akashks2006/Ball_Balancing_Robot/Images/image1.jpeg

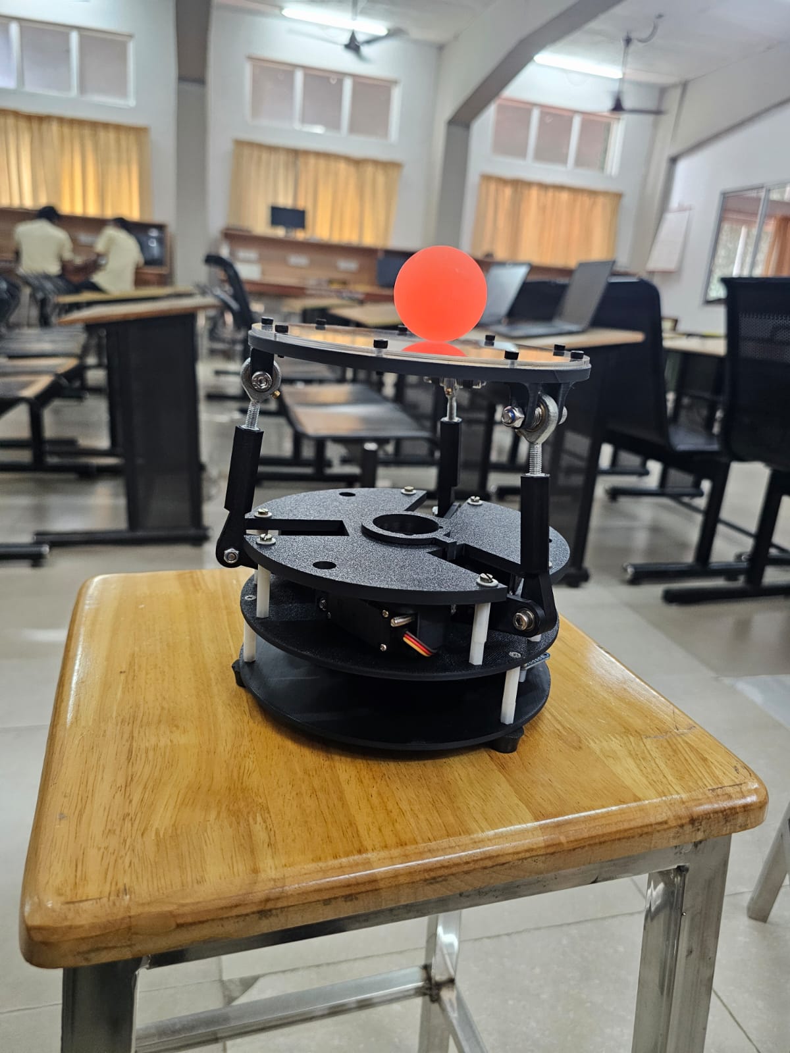
Images/image1.jpeg
