akashks2006/Ball_Balancing_Robot/Images/image2.jpeg

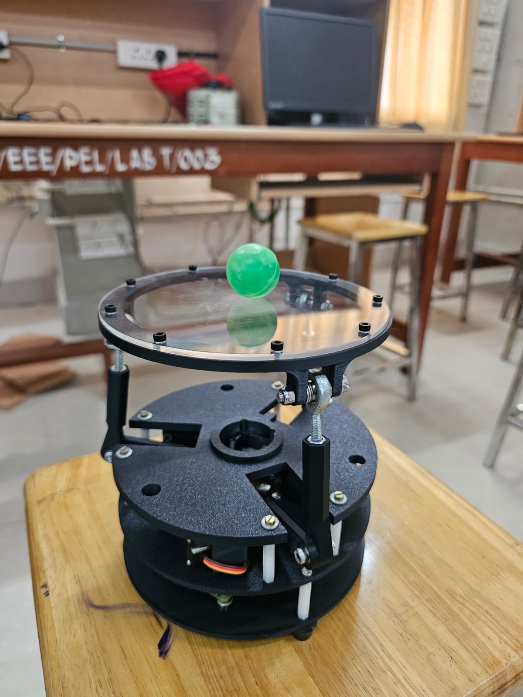
Images/image2.jpeg
