akashks2006/Ball_Balancing_Robot/Images/Simulation Dashboard.png

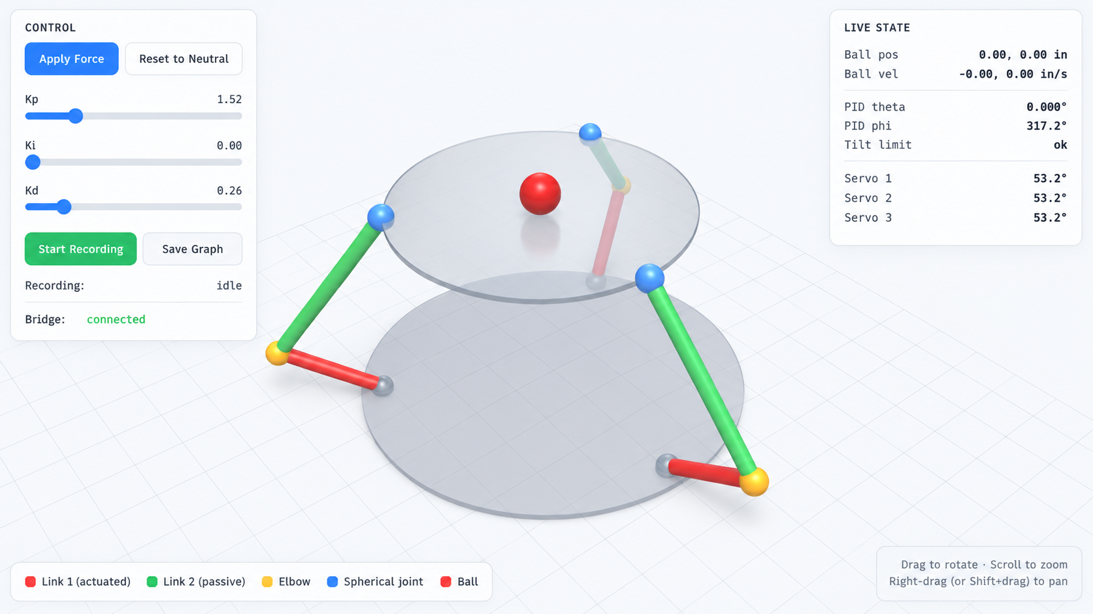
Images/Simulation Dashboard.png
