akashks2006/Ball_Balancing_Robot/Simulation/Graphs/Kd Only.png

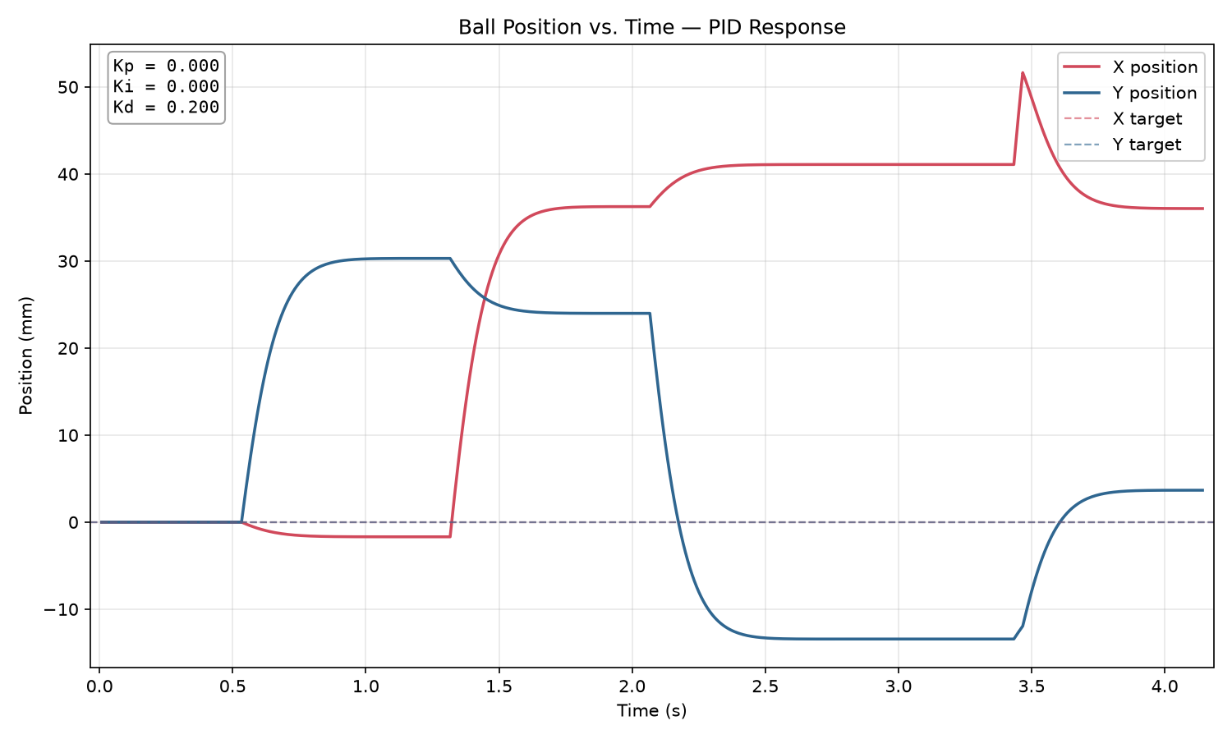
Simulation/Graphs/Kd Only.png
