akashks2006/Ball_Balancing_Robot/Simulation/Graphs/Ki + Kd.png

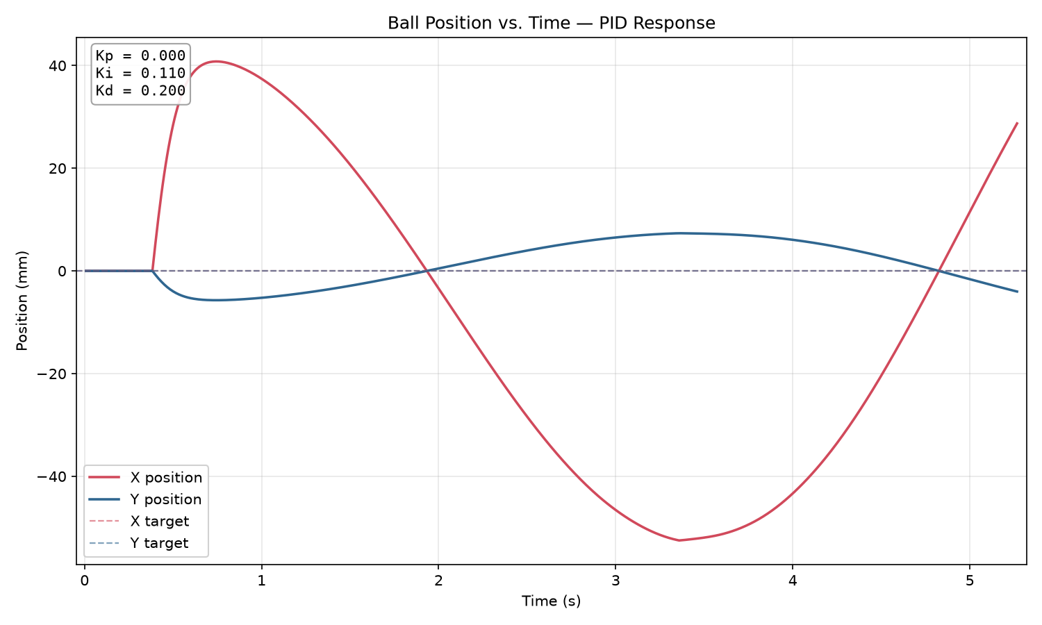
Simulation/Graphs/Ki + Kd.png
