akashks2006/Ball_Balancing_Robot/Simulation/Graphs/Ki Only.png

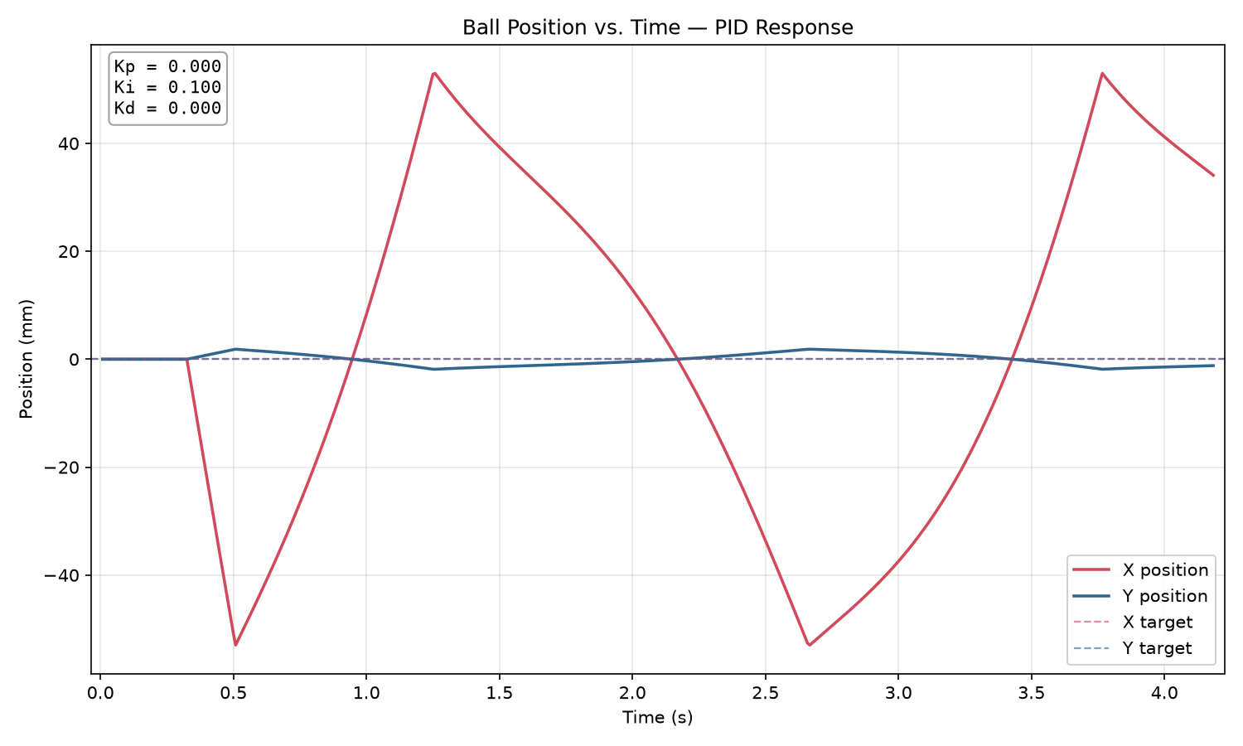
Simulation/Graphs/Ki Only.png
