akashks2006/Ball_Balancing_Robot/Simulation/Graphs/Kp + Kd.png

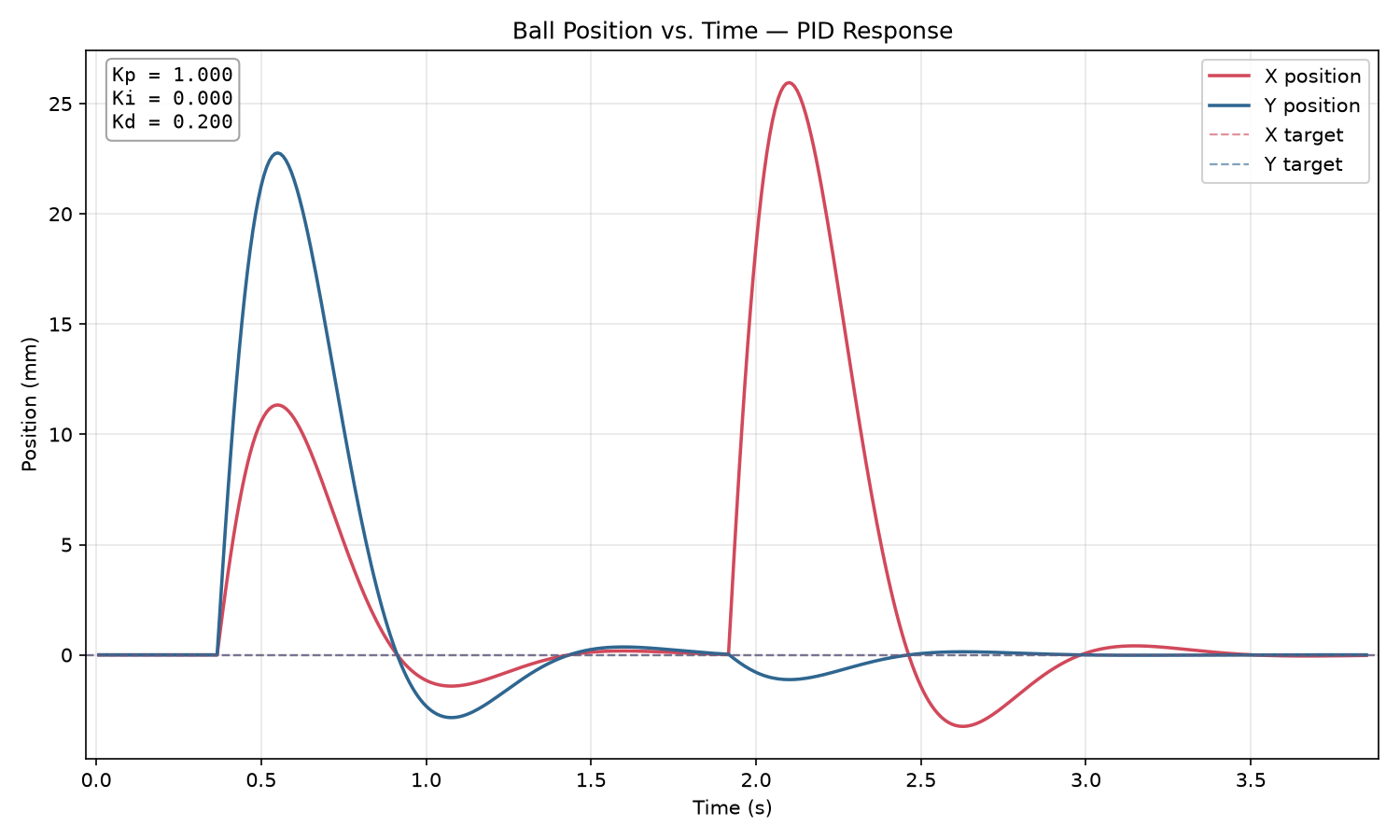
Simulation/Graphs/Kp + Kd.png
