akashks2006/Ball_Balancing_Robot/Simulation/Graphs/Kp + Ki.png

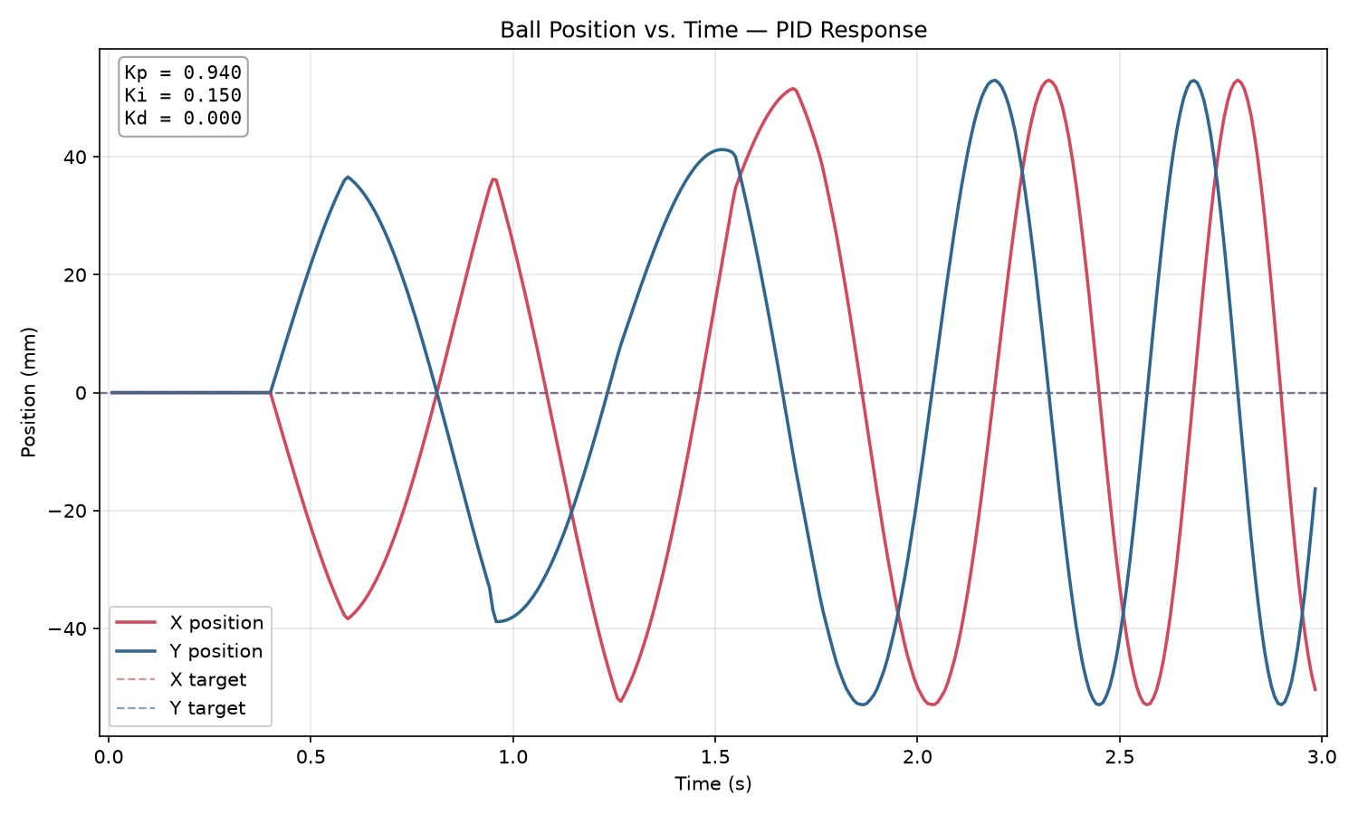
Simulation/Graphs/Kp + Ki.png
