akashks2006/Ball_Balancing_Robot/Simulation/Graphs/Kp Only.png

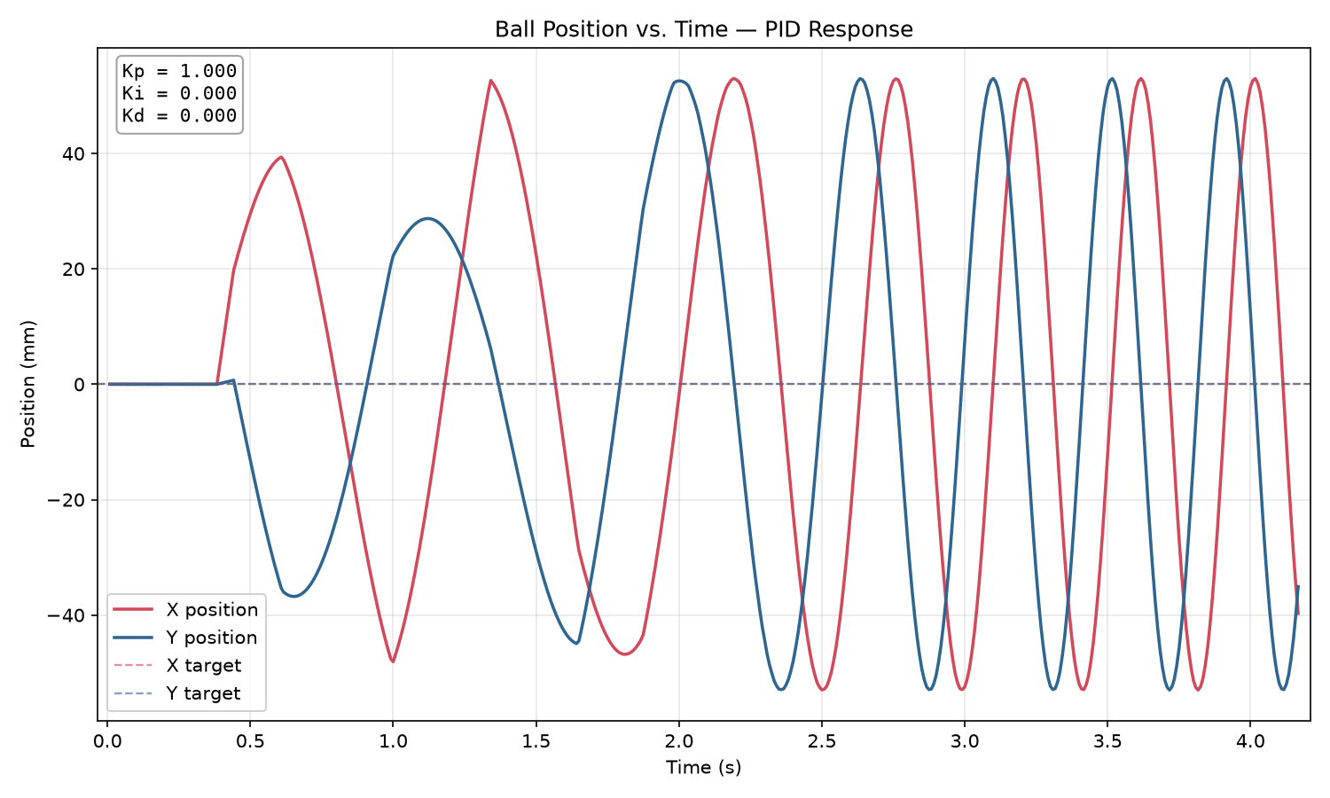
Simulation/Graphs/Kp Only.png
