akashks2006/Ball_Balancing_Robot/Simulation/Graphs/No PID.png

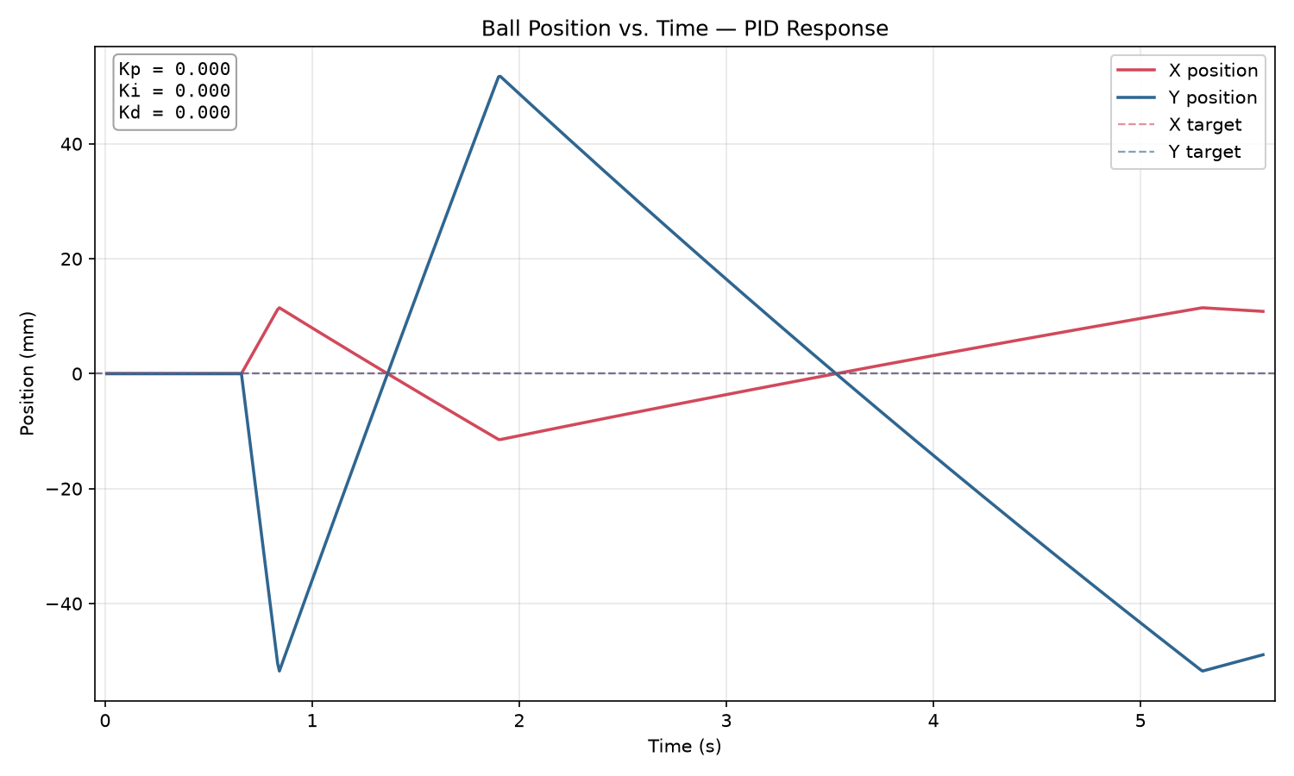
Simulation/Graphs/No PID.png
