akashks2006/Ball_Balancing_Robot/BOM & Wiring/Circuit Diagram.png

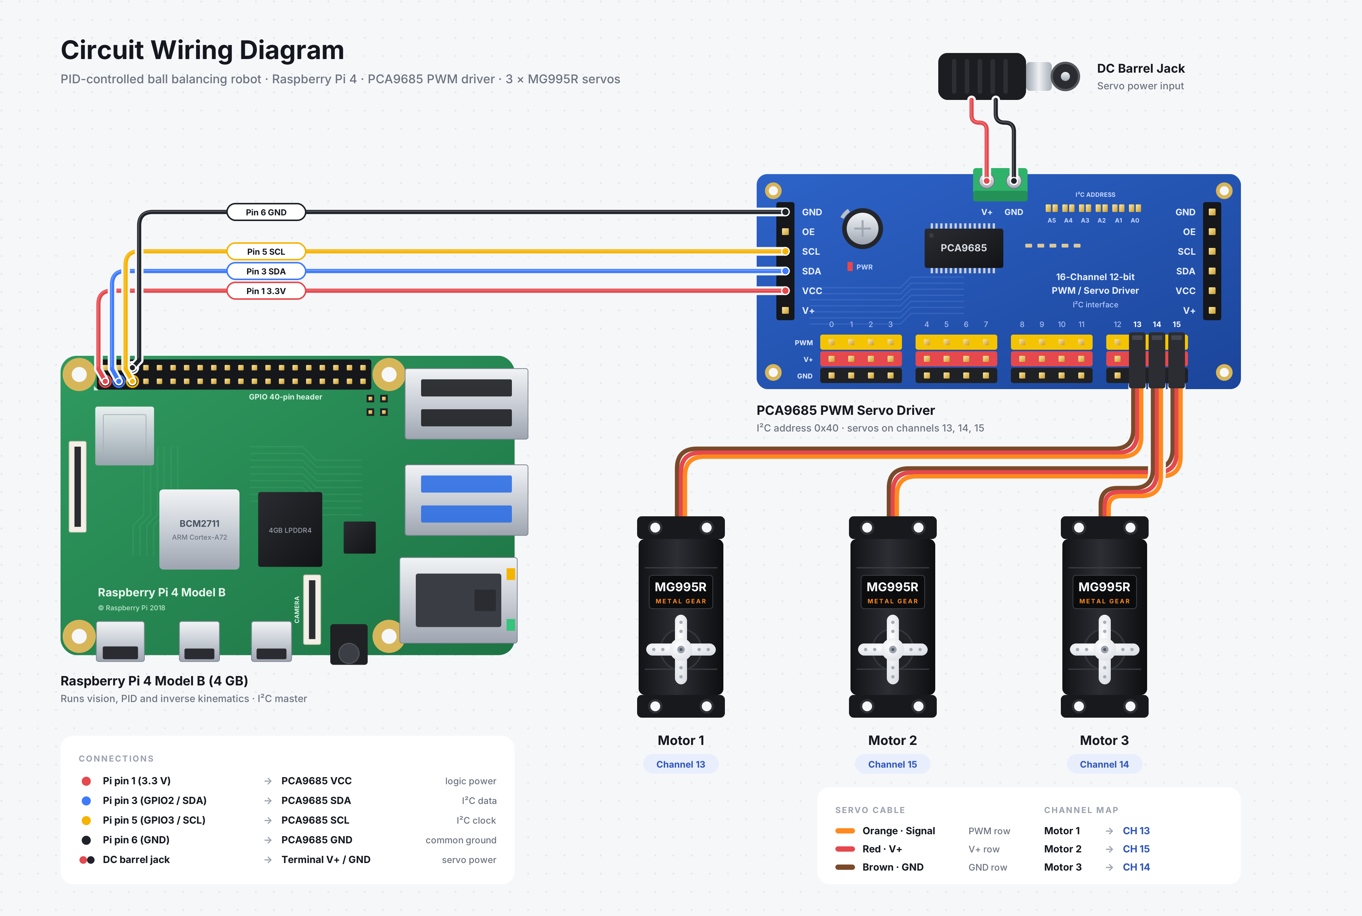
BOM & Wiring/Circuit Diagram.png
