akashks2006/Ball_Balancing_Robot/CAD/Base.stl

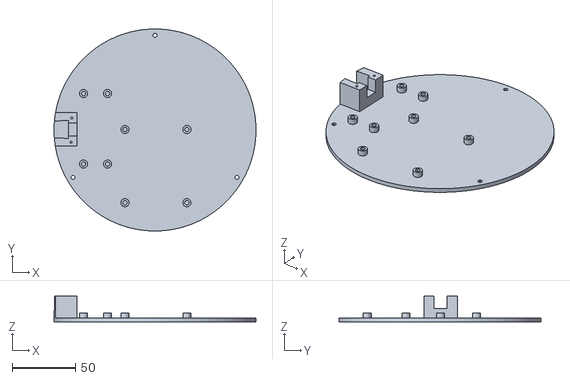
[picture p14: CAD file, 2026-10-29]
CAD/Base.stl
160.0 x 160.0 x 20.5
