akashks2006/Ball_Balancing_Robot/CAD/Camera_Mount.stl

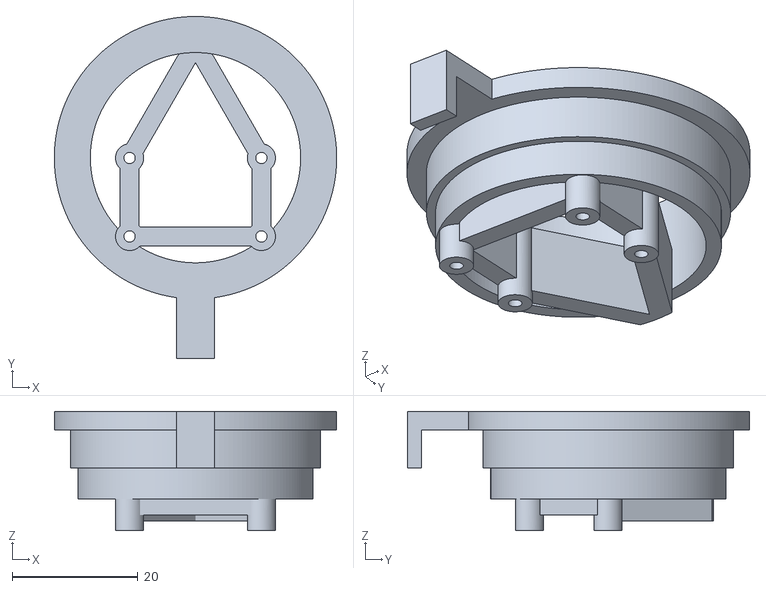
[picture p15: CAD file, 2026-10-29]
CAD/Camera_Mount.stl
45.0 x 54.5 x 19.0
