akashks2006/Ball_Balancing_Robot/CAD/Barrel_Jack_Cover.stl

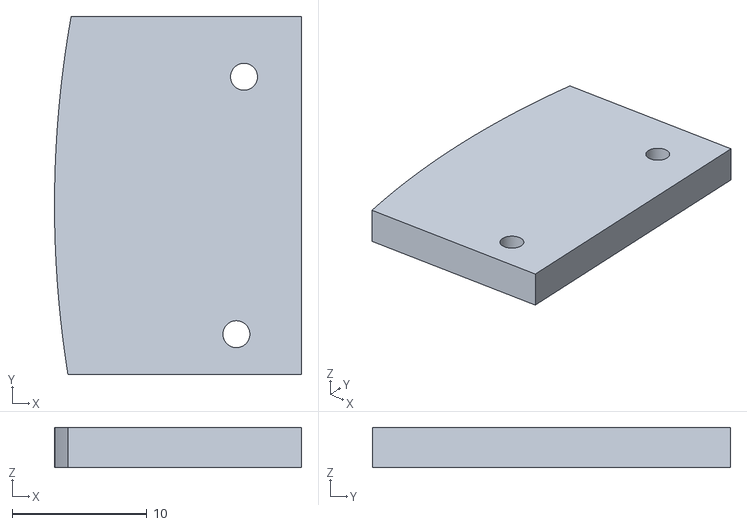
[picture p16: CAD file, 2026-10-29]
CAD/Barrel_Jack_Cover.stl
18.3 x 26.6 x 3.00
