akashks2006/Ball_Balancing_Robot/CAD/Border.stl

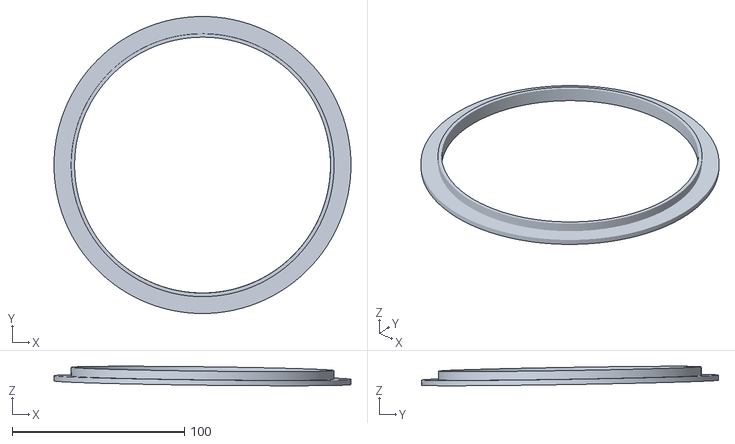
[picture p17: CAD file, 2026-10-29]
CAD/Border.stl
172.5 x 172.5 x 11.4
