akashks2006/Ball_Balancing_Robot/CAD/Link_1_Upper_Arm.step

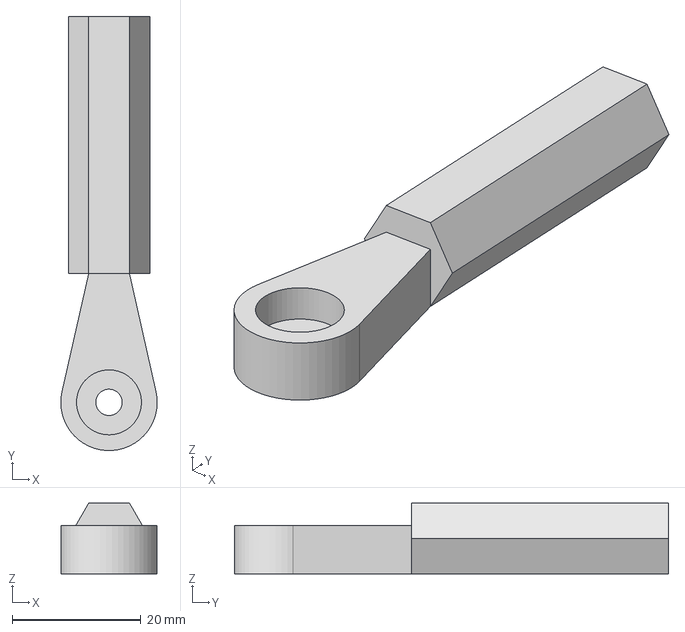
[picture p18: CAD file, 2026-10-29]
CAD/Link_1_Upper_Arm.step
15.0 x 67.5 x 11.0 mm
