akashks2006/Ball_Balancing_Robot/CAD/Top_Ring.step

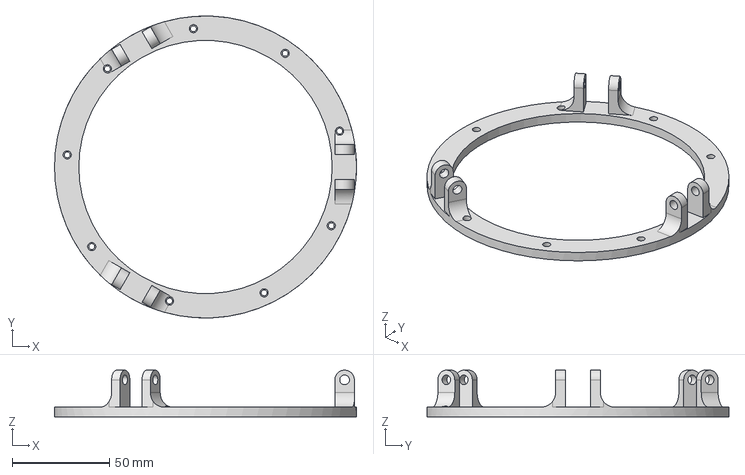
[picture p19: CAD file, 2026-10-29]
CAD/Top_Ring.step
155.0 x 154.9 x 24.0 mm
