akashks2006/Ball_Balancing_Robot/CAD/Middle_Plate.step

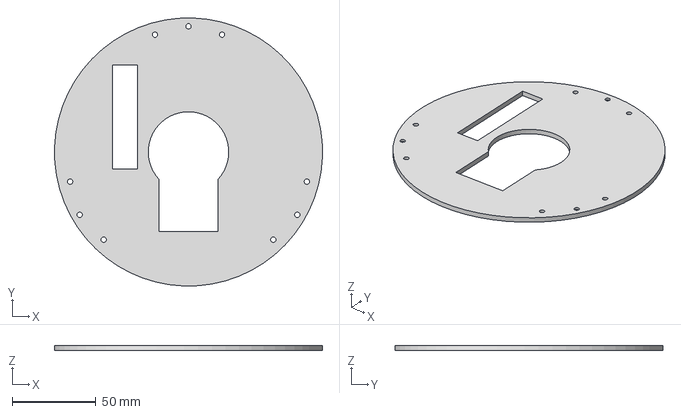
[picture p20: CAD file, 2026-10-29]
CAD/Middle_Plate.step
159.9 x 159.9 x 3.00 mm
