akashks2006/Ball_Balancing_Robot/CAD/Link_2_Lower_Arm.step

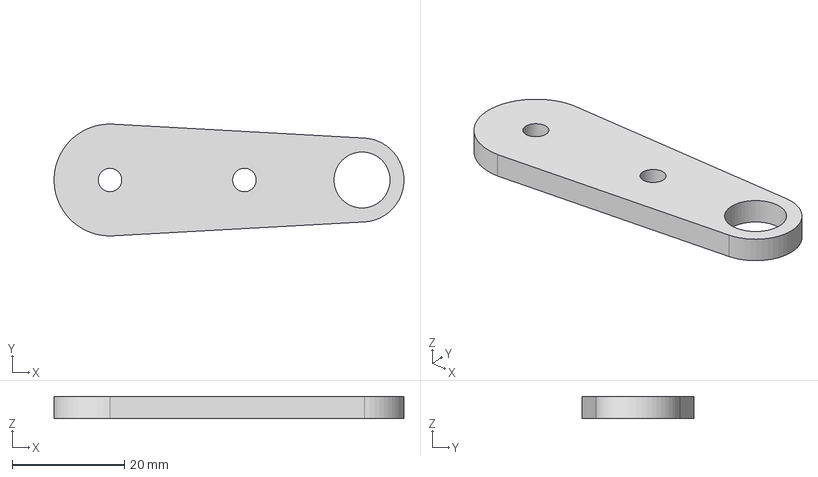
[picture p21: CAD file, 2026-10-29]
CAD/Link_2_Lower_Arm.step
62.5 x 20.0 x 4.00 mm
