akashks2006/Ball_Balancing_Robot/CAD/Top_Servo_Mount.step

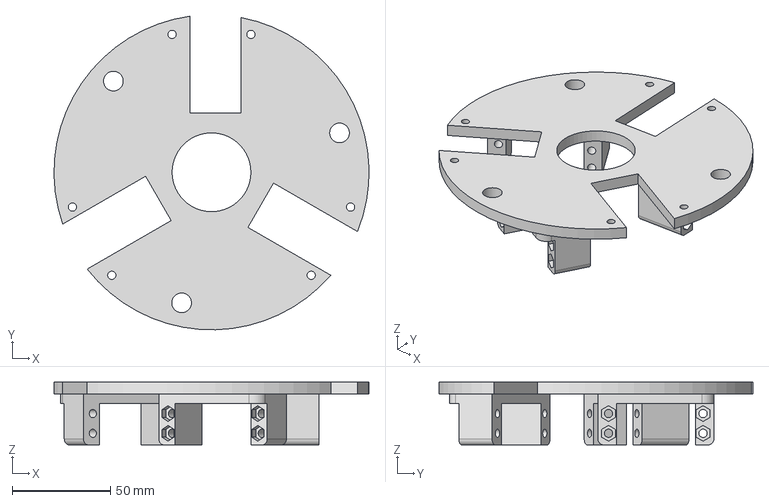
[picture p22: CAD file, 2026-10-29]
CAD/Top_Servo_Mount.step
159.9 x 159.2 x 31.9 mm
